TkkrLab/tkkrLaser/README.md

# tkkrLaser
Description, usage and maintenance of the tkkrLaser lasercutter
