TkkrLab/tkkrLaser/schematics/opt-lasercutter.sch

## EAGLE design schematics/opt-lasercutter.sch (2018-05-26)

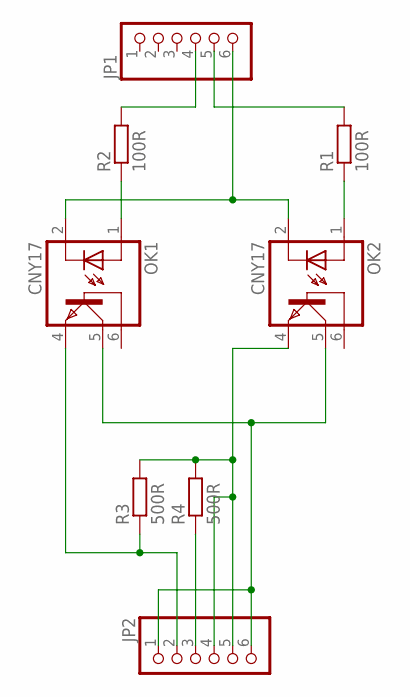
[picture p3: schematic opt-lasercutter.sch]

Parts:
JP1, JP2: PINHD-1X6/90; 1X06/90
OK1, OK2: CNY17; DIL06
R1, R2: 100R; 0207/7
R3, R4: 500R; 0207/7

Connections:
unnamed: JP1.6, OK1.2 (C), OK2.2 (C)
unnamed: JP1.5, R1.2
unnamed: OK2.1 (A), R1.1
unnamed: JP1.4, R2.2
unnamed: OK1.1 (A), R2.1
unnamed: JP2.1, JP2.6, OK1.5 (COL), OK2.5 (COL)
unnamed: JP2.4, JP2.5, OK2.4 (EMI), R3.2, R4.2
unnamed: JP2.3, R4.1
unnamed: JP2.2, OK1.4 (EMI), R3.1
