TkkrLab/tkkrLaser/smoothie-board-config.txt

default_feed_rate                            8000
default_seek_rate                            8000
mm_per_arc_segment                           0.5
mm_max_arc_error                             0.01
alpha_steps_per_mm                           158.2
beta_steps_per_mm                            158.2
planner_queue_size                           8
acceleration                                 300
junction_deviation                           0.05
microseconds_per_step_pulse                  1
base_stepping_frequency                      100000
x_axis_max_speed                             30000
y_axis_max_speed                             30000
alpha_step_pin                               2.8
alpha_dir_pin                                2.13!
alpha_en_pin                                 4.29
alpha_current                                1.2
alpha_max_rate                               10000.0
beta_step_pin                                2.3
beta_dir_pin                                 0.22
beta_en_pin                                  0.21
beta_current                                 1.2
beta_max_rate                                10000.0
uart0.baud_rate                              115200
second_usb_serial_enable                     false
currentcontrol_module_enable                 true
extruder.hotend.enable                       false
extruder.hotend2.enable                      false
laser_module_enable                          true
laser_module_pin                             1.23
laser_module_ttl_pin                         !1.22
laser_module_maximum_power                   0.8
laser_module_minimum_power                   0.04
laser_module_pwm_period                      25
temperature_control.hotend.enable            false
temperature_control.hotend2.enable           false
temperature_control.bed.enable               false
switch.fan.enable                            false
switch.fan.input_on_command                  M106
switch.fan.input_off_command                 M107
switch.fan.output_pin                        nc
switch.fan.output_type                       pwm
switch.spindle.enable                        false
endstops_enable                              true
alpha_min_endstop                            1.24^
alpha_max_endstop                            nc
alpha_homing_direction                       home_to_min
alpha_min                                    -13
alpha_max                                    400
beta_min_endstop                             1.25^
beta_max_endstop                             nc
beta_homing_direction                        home_to_min
beta_min                                     -8
beta_max                                     300
alpha_limit_enable                           true
beta_limit_enable                            true
alpha_fast_homing_rate_mm_s                  50
beta_fast_homing_rate_mm_s                   50
gamma_fast_homing_rate_mm_s                  3
alpha_slow_homing_rate_mm_s                  25
beta_slow_homing_rate_mm_s                   25
gamma_slow_homing_rate_mm_s                  2
alpha_homing_retract_mm                      13
beta_homing_retract_mm                       8
gamma_homing_retract_mm                      1
zprobe.enable                                false
panel.enable                                 true
panel.lcd                                    reprap_discount_glcd
panel.spi_channel                            1
panel.spi_cs_pin                             0.16
panel.encoder_a_pin                          1.31
panel.encoder_b_pin                          1.33
panel.click_button_pin                       nc
panel.buzz_pin                               0.37
panel.back_button_pin                        nc
panel.up_button_pin                          nc
panel.down_button_pin                        nc
network.enable                               true
network.webserver.enable                     true
network.telnet.enable                        true
network.ip_address                           auto
