TkkrLab/tkkrLaser/(commit log)

2018-05-25 Added lens and mirrors
2018-05-25 Added laser tube
2018-05-25 Added laser-callibration.svg
2018-05-25 added laser cutting
    [smoothie-board-config.txt]
2018-05-30 updated lens
